5881/mp3-player/schematic and pcb/mp3-1.gif

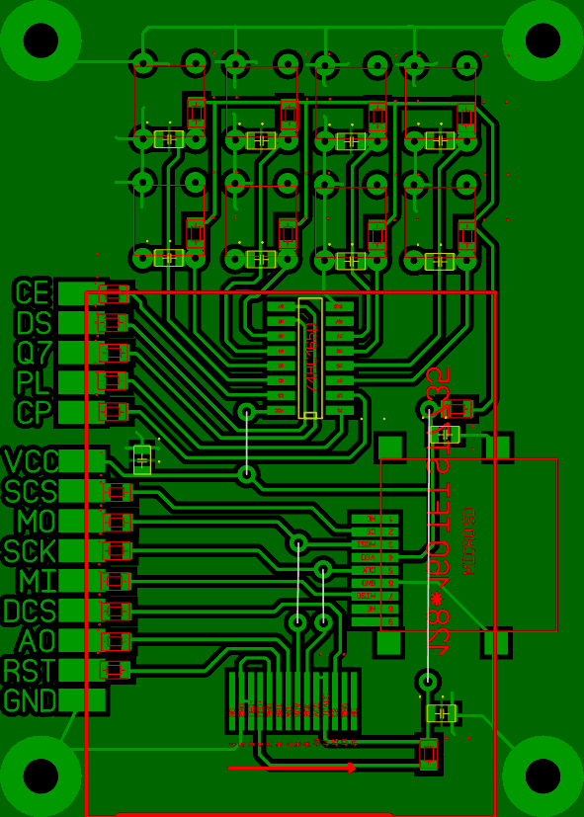
schematic and pcb/mp3-1.gif
