5881/mp3-player/schematic and pcb/mp3-2.gif

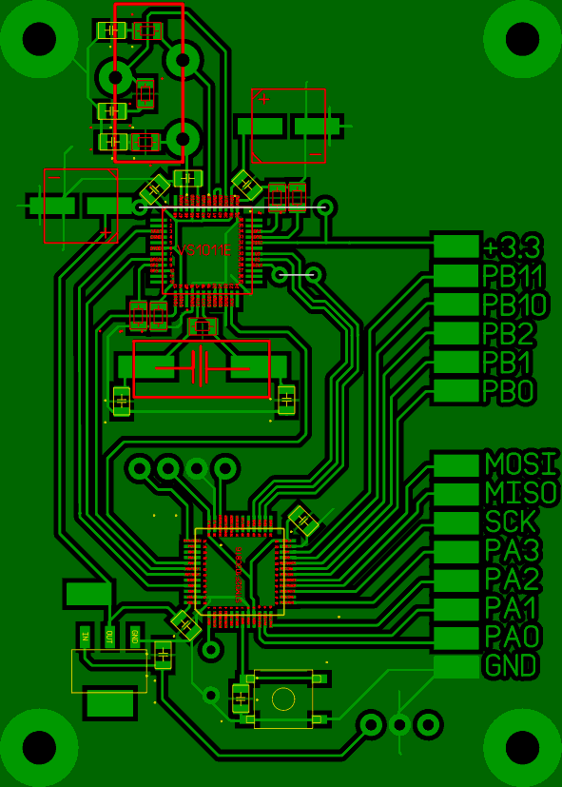
schematic and pcb/mp3-2.gif
