5881/mp3-player/schematic and pcb/mp3.png

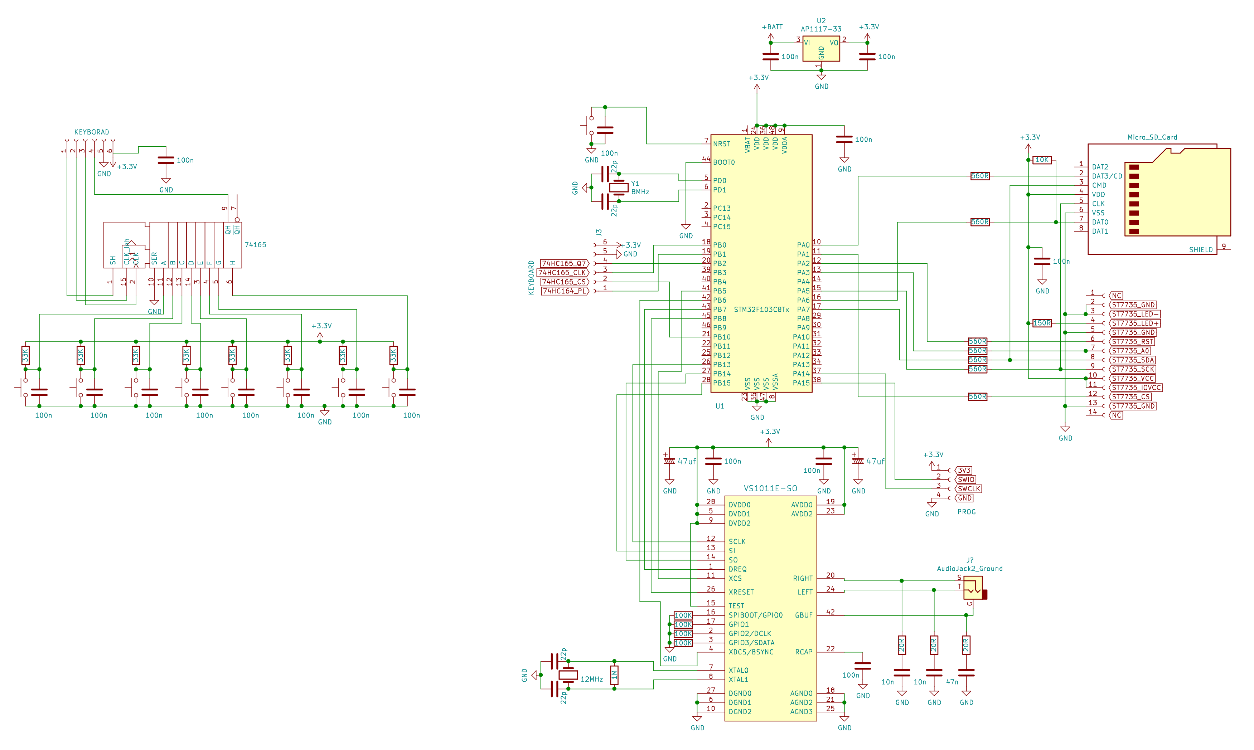
schematic and pcb/mp3.png
