5881/mp3-player/schematic and pcb/mp3.pdf

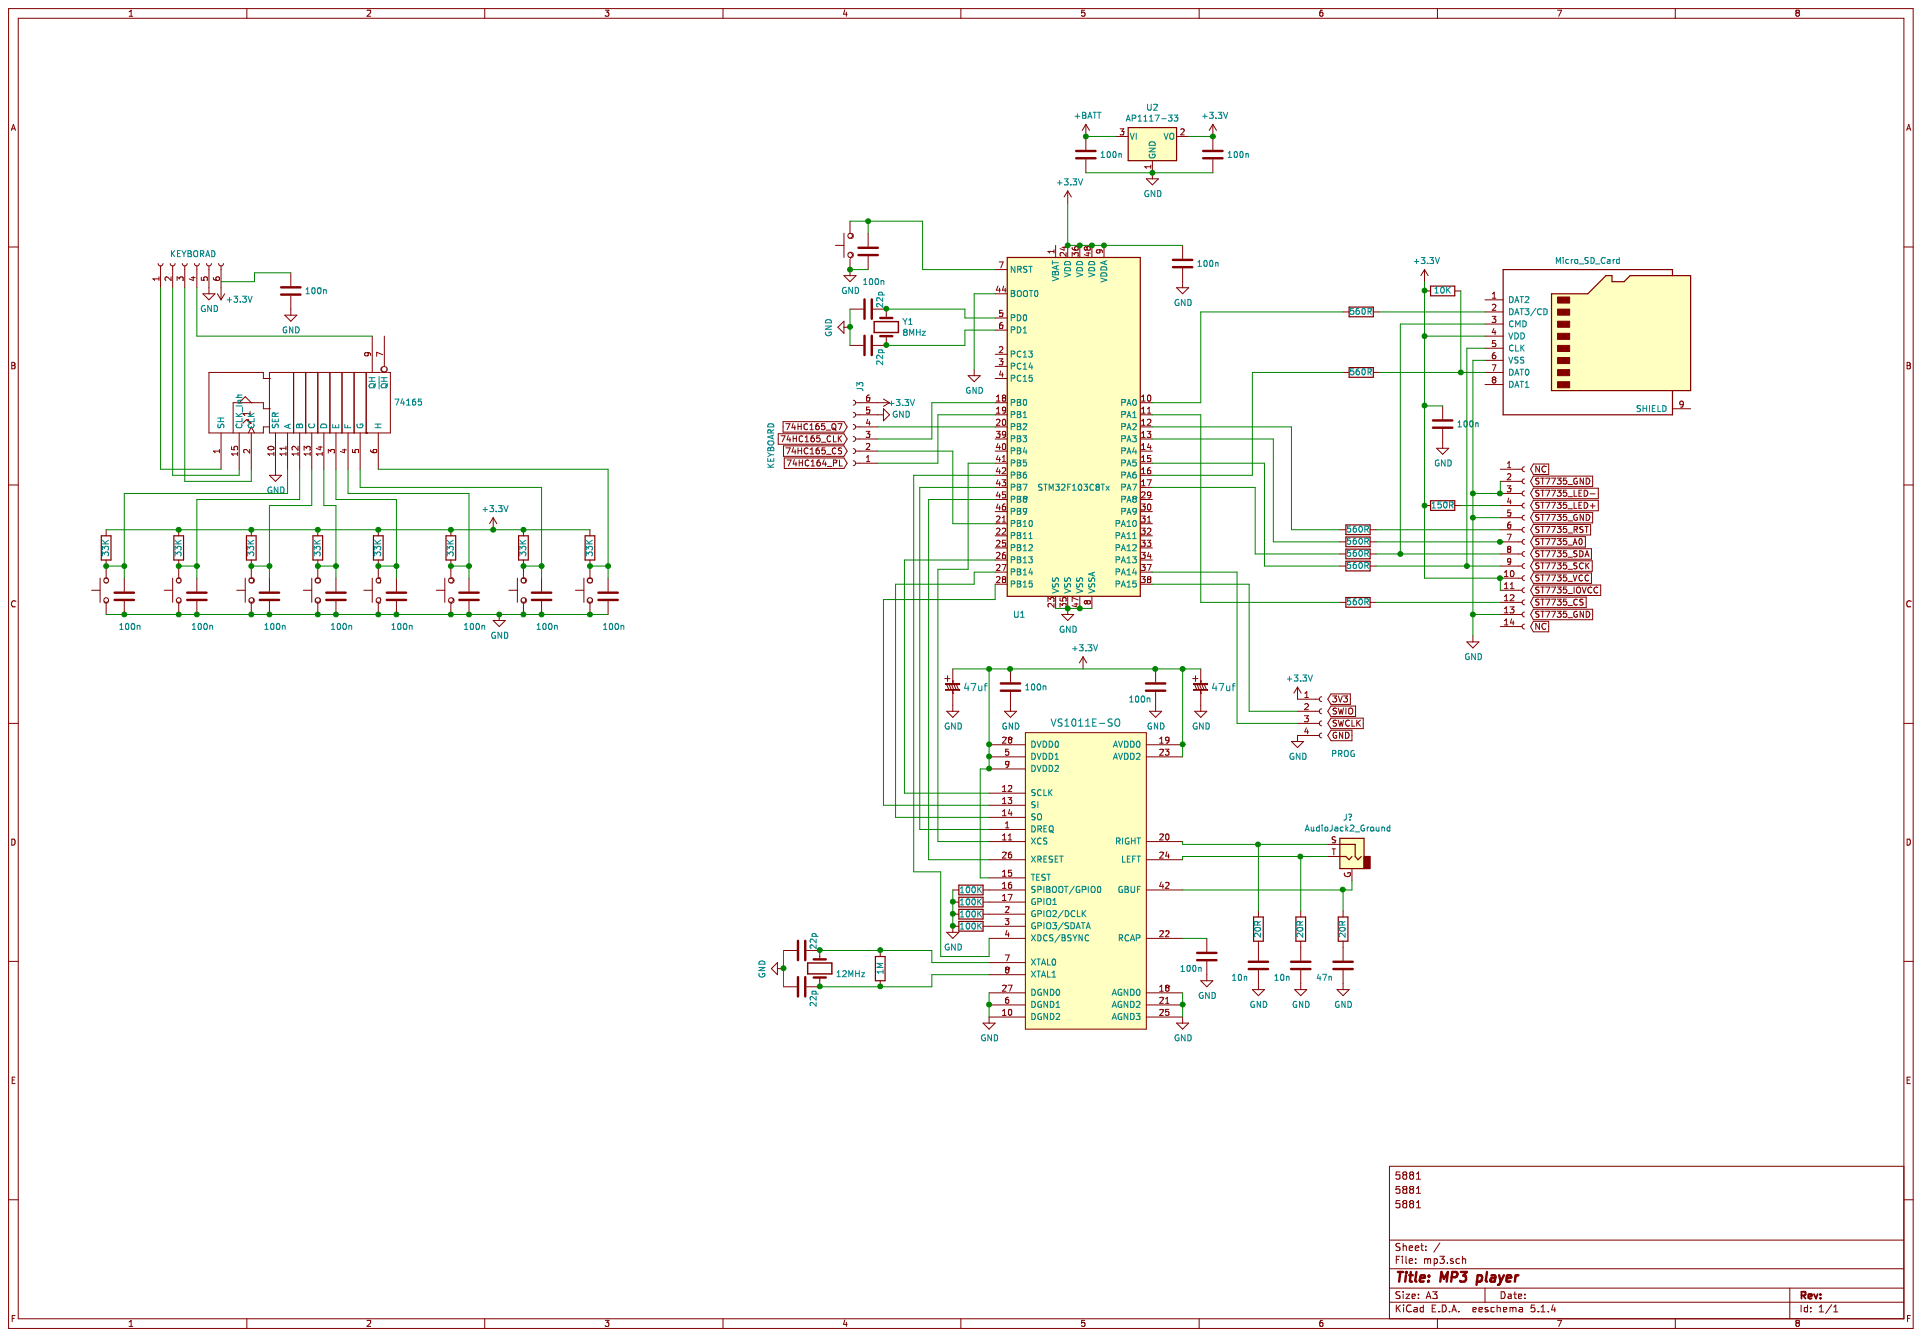
[picture p4: page 1]
