5881/mp3-player/(list of files, drawings)

Other design files:
schematic and pcb/mp3-1.lay6
schematic and pcb/mp3-2.lay6
