5881/mp3-player/schematic and pcb/mp3.sch

## KiCad design schematic and pcb/mp3.sch (2019-12-15)

Schematic: mp3.sch

Parts:
C1, C2, C12, C14, C16, C18, C20, C22, C24, C26, C27: 100n; C_0805_2012Metric
C34, C35: 22p; C_0805_2012Metric
J2: KEYBORAD
J3: KEYBOARD
R2, R4, R6, R8, R10, R12, R14, R16: 33K; R_0805_2012Metric
SW2, SW4, SW6, SW8, SW10, SW12, SW14, SW16: SW_Push; SW_PUSH_6mm
U1: STM32F103C8Tx; LQFP-48_7x7mm_P0.5mm
U2: AP1117-33; SOT-223-3_TabPin2
U6: 74165; SOIC-16_3.9x9.9mm_P1.27mm
Y1: 8MHz; Crystal_SMD_Abracon_ABM3-2Pin_5.0x3.2mm
