5881/mp3-player/inc/st7735_128x160.c

/*Библиотека для работы с tft дисплеем 128x128 st7735
 * v 0.9
 * использована libopencm3
 * 16 mar 2019
 * Alexander Belyy
 * 
 * v0.91
 * добавлено масштабирование текста х2
 * v0.92
 * добавлен вывод побайтно как в терминале 12 мая 2019
 * v0.93
 * добавлена поддержка backspase \b 27 июля 2019
 * v0.94
 * Привёл к пристойному виду. 28 июля 2019
 * v0.95
 * Исправлен баг с CS приводящий к артефактам
 * ошибка была в функции send_char()
 * 10 ноября 2019
 * Добавлена поддержка русской UTF8
 * v0.96
 * 17 ноября 2019
 * исправлена ошибка с печатью первого символа после очистки экрана в
 * st7735_sendchar();
 * 18 ноября 2019
 */
#include <stdint.h>
#include <string.h>
#include <libopencm3/stm32/gpio.h>
#include <libopencm3/stm32/spi.h>
#include "st7735_128x160.h"

/*********************************************************************
 * Секция переменных
 *********************************************************************/
uint16_t pos=0;
static uint16_t txt_color=GREEN;
static uint16_t bg_color=BLACK;

#ifdef UTF8ASCII

//псевдо utf8
//до 00x7f ascii после кирилическая страница без перфиксов
static const char ASCII[][5] =
{
 {0x00, 0x00, 0x00, 0x00, 0x00} // 20  
,{0x00, 0x00, 0x5f, 0x00, 0x00} // 21 !
,{0x00, 0x07, 0x00, 0x07, 0x00} // 22 "
,{0x14, 0x7f, 0x14, 0x7f, 0x14} // 23 #
,{0x24, 0x2a, 0x7f, 0x2a, 0x12} // 24 $
,{0x23, 0x13, 0x08, 0x64, 0x62} // 25 %
,{0x36, 0x49, 0x55, 0x22, 0x50} // 26 &
,{0x00, 0x05, 0x03, 0x00, 0x00} // 27 '
,{0x00, 0x1c, 0x22, 0x41, 0x00} // 28 (
,{0x00, 0x41, 0x22, 0x1c, 0x00} // 29 )
,{0x14, 0x08, 0x3e, 0x08, 0x14} // 2a *
,{0x08, 0x08, 0x3e, 0x08, 0x08} // 2b +
,{0x00, 0x50, 0x30, 0x00, 0x00} // 2c ,
,{0x08, 0x08, 0x08, 0x08, 0x08} // 2d -
,{0x00, 0x60, 0x60, 0x00, 0x00} // 2e .
,{0x20, 0x10, 0x08, 0x04, 0x02} // 2f /
,{0x3e, 0x51, 0x49, 0x45, 0x3e} // 30 0
,{0x00, 0x42, 0x7f, 0x40, 0x00} // 31 1
,{0x42, 0x61, 0x51, 0x49, 0x46} // 32 2
,{0x21, 0x41, 0x45, 0x4b, 0x31} // 33 3
,{0x18, 0x14, 0x12, 0x7f, 0x10} // 34 4
,{0x27, 0x45, 0x45, 0x45, 0x39} // 35 5
,{0x3c, 0x4a, 0x49, 0x49, 0x30} // 36 6
,{0x01, 0x71, 0x09, 0x05, 0x03} // 37 7
,{0x36, 0x49, 0x49, 0x49, 0x36} // 38 8
,{0x06, 0x49, 0x49, 0x29, 0x1e} // 39 9
,{0x00, 0x36, 0x36, 0x00, 0x00} // 3a :
,{0x00, 0x56, 0x36, 0x00, 0x00} // 3b ;
,{0x08, 0x14, 0x22, 0x41, 0x00} // 3c <
,{0x14, 0x14, 0x14, 0x14, 0x14} // 3d =
,{0x00, 0x41, 0x22, 0x14, 0x08} // 3e >
,{0x02, 0x01, 0x51, 0x09, 0x06} // 3f ?
,{0x32, 0x49, 0x79, 0x41, 0x3e} // 40 @
,{0x7e, 0x11, 0x11, 0x11, 0x7e} // 41 A
,{0x7f, 0x49, 0x49, 0x49, 0x36} // 42 B
,{0x3e, 0x41, 0x41, 0x41, 0x22} // 43 C
,{0x7f, 0x41, 0x41, 0x22, 0x1c} // 44 D
,{0x7f, 0x49, 0x49, 0x49, 0x41} // 45 E
,{0x7f, 0x09, 0x09, 0x09, 0x01} // 46 F
,{0x3e, 0x41, 0x49, 0x49, 0x7a} // 47 G
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
};

#else

static const char ASCII[][5] =
{
 {0x00, 0x00, 0x00, 0x00, 0x00} // 20  
,{0x00, 0x00, 0x5f, 0x00, 0x00} // 21 !
,{0x00, 0x07, 0x00, 0x07, 0x00} // 22 "
,{0x14, 0x7f, 0x14, 0x7f, 0x14} // 23 #
,{0x24, 0x2a, 0x7f, 0x2a, 0x12} // 24 $
,{0x23, 0x13, 0x08, 0x64, 0x62} // 25 %
,{0x36, 0x49, 0x55, 0x22, 0x50} // 26 &
,{0x00, 0x05, 0x03, 0x00, 0x00} // 27 '
,{0x00, 0x1c, 0x22, 0x41, 0x00} // 28 (
,{0x00, 0x41, 0x22, 0x1c, 0x00} // 29 )
,{0x14, 0x08, 0x3e, 0x08, 0x14} // 2a *
,{0x08, 0x08, 0x3e, 0x08, 0x08} // 2b +
,{0x00, 0x50, 0x30, 0x00, 0x00} // 2c ,
,{0x08, 0x08, 0x08, 0x08, 0x08} // 2d -
,{0x00, 0x60, 0x60, 0x00, 0x00} // 2e .
,{0x20, 0x10, 0x08, 0x04, 0x02} // 2f /
,{0x3e, 0x51, 0x49, 0x45, 0x3e} // 30 0
,{0x00, 0x42, 0x7f, 0x40, 0x00} // 31 1
,{0x42, 0x61, 0x51, 0x49, 0x46} // 32 2
,{0x21, 0x41, 0x45, 0x4b, 0x31} // 33 3
,{0x18, 0x14, 0x12, 0x7f, 0x10} // 34 4
,{0x27, 0x45, 0x45, 0x45, 0x39} // 35 5
,{0x3c, 0x4a, 0x49, 0x49, 0x30} // 36 6
,{0x01, 0x71, 0x09, 0x05, 0x03} // 37 7
,{0x36, 0x49, 0x49, 0x49, 0x36} // 38 8
,{0x06, 0x49, 0x49, 0x29, 0x1e} // 39 9
,{0x00, 0x36, 0x36, 0x00, 0x00} // 3a :
,{0x00, 0x56, 0x36, 0x00, 0x00} // 3b ;
,{0x08, 0x14, 0x22, 0x41, 0x00} // 3c <
,{0x14, 0x14, 0x14, 0x14, 0x14} // 3d =
,{0x00, 0x41, 0x22, 0x14, 0x08} // 3e >
,{0x02, 0x01, 0x51, 0x09, 0x06} // 3f ?
,{0x32, 0x49, 0x79, 0x41, 0x3e} // 40 @
,{0x7e, 0x11, 0x11, 0x11, 0x7e} // 41 A
,{0x7f, 0x49, 0x49, 0x49, 0x36} // 42 B
,{0x3e, 0x41, 0x41, 0x41, 0x22} // 43 C
,{0x7f, 0x41, 0x41, 0x22, 0x1c} // 44 D
,{0x7f, 0x49, 0x49, 0x49, 0x41} // 45 E
,{0x7f, 0x09, 0x09, 0x09, 0x01} // 46 F
,{0x3e, 0x41, 0x49, 0x49, 0x7a} // 47 G
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
};
#endif

 /********************************************************************
  * Секция основных функций
  ********************************************************************/
void st7735_set_printf_color(uint16_t textcolor, uint16_t bgcolor){
	txt_color=textcolor;
	bg_color=bgcolor;	
}


void st7735_sendcmd(unsigned char cmd){
	gpio_clear(STPORT, DC);
	spi_send(SPI,cmd);
	while (SPI_SR(SPI) & SPI_SR_BSY);
	}
void st7735_senddata(unsigned char data){
	gpio_set(STPORT, DC);
	spi_send(SPI,data);
	while (SPI_SR(SPI) & SPI_SR_BSY);
	}

void st7735_init(void){
	uint32_t i;
	
	//for(i=0;i<0xfff;i++)__asm__("nop");
	gpio_set(STPORT,RST);
	gpio_clear(STPORT,STCS);
	for(i=0;i<0xfff;i++)__asm__("nop");
	gpio_clear(STPORT,RST);
	for(i=0;i<0xfff;i++)__asm__("nop");
	gpio_set(STPORT,RST);
	
	st7735_sendcmd(ST7735_SWRESET);//0x01
	for(i=0;i<0x5fff;i++)__asm__("nop");
	
	st7735_sendcmd(ST7735_SLPOUT);//0x11
	for(i=0;i<0x5fff;i++)__asm__("nop");
	
	st7735_sendcmd(ST7735_COLMOD);
	st7735_senddata(0x5);
	st7735_sendcmd(0x26);
	st7735_senddata(0x2);
	
	st7735_sendcmd(ST7735_FRMCTR1);
	st7735_senddata(0x00);
	st7735_senddata(0x06);
	st7735_senddata(0x03);
	
	st7735_sendcmd(ST7735_MADCTL);
#ifdef HORIZONTAL
	st7735_senddata(MV|MX); //mv set def is 0
#else
	st7735_senddata(0x0);
#endif
	//st7735_sendcmd(ST7735_DISSET5);
	//st7735_senddata(0x15);
	//st7735_senddata(0x02);

	
	st7735_sendcmd(ST7735_CASET);
	st7735_senddata(0x00);
	st7735_senddata(0x00);
	st7735_senddata(0x00);
	st7735_senddata(0x7f);

	st7735_sendcmd(ST7735_RASET);
	st7735_senddata(0x00);
	st7735_senddata(0x00);
	st7735_senddata(0x00);
	st7735_senddata(0xa0);

	
	
	st7735_sendcmd(ST7735_NORON);
	for(i=0;i<0xfff;i++)__asm__("nop");
	
	st7735_sendcmd(ST7735_DISPON);
	for(i=0;i<0xfff;i++)__asm__("nop");
	
		
	while (SPI_SR(SPI) & SPI_SR_BSY);
	gpio_set(GPIOA,STCS);
}

void st7735_wake(void){
	//st7735_init();
	gpio_clear(STPORT,STCS);
	st7735_sendcmd(ST7735_DISPON);
	gpio_set(STPORT,STCS);
	gpio_set(GPIOB,GPIO0);
	}

void st7735_sleep(void){
	gpio_clear(STPORT,STCS);
	st7735_sendcmd(ST7735_DISPOFF);
	gpio_set(STPORT,STCS);
	gpio_clear(GPIOB,GPIO0);
	}

void st7735_addrset(unsigned char sx,unsigned char sy,
								unsigned char ex,unsigned char ey){
	st7735_sendcmd(ST7735_CASET); // Column address set 2a
	gpio_set(GPIOA,DC);
	spi_send(SPI,0x00);
	spi_send(SPI,sx);
	spi_send(SPI,0x00);
	spi_send(SPI,ex);

	while (SPI_SR(SPI) & SPI_SR_BSY);

	st7735_sendcmd(ST7735_RASET);   // Row address set 2b
	gpio_set(GPIOA,DC);
	spi_send(SPI,0x00);
	spi_send(SPI,sy);
	spi_send(SPI,0x00);
	spi_send(SPI,ey);
	
	while (SPI_SR(SPI) & SPI_SR_BSY);
	st7735_sendcmd(ST7735_RAMWR);   // Memory write			
	}

void st7735_clear(uint16_t color){
	unsigned char BCH,BCL;
	BCL = color & 0xFF;
	BCH = color>>8;
	gpio_clear(STPORT,STCS);
	//for(uint8_t i=0;i<0xff;i++)__asm__("nop");

#ifdef HORIZONTAL
	st7735_addrset(0,0,160,128);
#else
	st7735_addrset(0,0,128,160);
#endif
	gpio_set(STPORT,DC);
	for(uint16_t i=0;i<128*160;i++){
		spi_send(SPI,BCH);
		spi_send(SPI,BCL);
		}
	while (SPI_SR(SPI) & SPI_SR_BSY);
	gpio_set(STPORT,STCS);
	}

//debug func

void st7735_draw_s_char(unsigned char x,unsigned char y,char chr,
								uint16_t color, uint16_t bg_color){
										
	unsigned char i,j;
	unsigned char CH,CL,BCH,BCL;
	unsigned char buffer[6];
	CL = color & 0xFF;
	CH = color>>8;
	BCL = bg_color & 0xFF;
	BCH = bg_color>>8;
	
	memcpy(buffer,&ASCII[chr-0x20],5);
	buffer[5]=0;
	
	gpio_clear(STPORT,STCS);
	st7735_addrset(x,y,x+5,y+7);
	gpio_set(GPIOA,DC);
	for(unsigned char i=0;i<8;i++){
		for(unsigned char j=0;j<6;j++){
			if((buffer[j] & (1<<i))){
				spi_send(SPI,CH);
				spi_send(SPI,CL);
				}
				else{
				spi_send(SPI,BCH);
				spi_send(SPI,BCL);
				}
			}
		}
	
	while (SPI_SR(SPI) & SPI_SR_BSY);
	gpio_set(STPORT,STCS);

}

//end debug func

void st7735_drawchar(unsigned char x,unsigned char y,char chr,
								uint16_t color, uint16_t bg_color){
	gpio_clear(STPORT,STCS);
	unsigned char i,j;
	unsigned char CH,CL,BCH,BCL;
	unsigned char buffer[6];
	//добавлена поддержка кирилицы
	unsigned char c=(chr<0xe0) ? chr - 0x20 : chr - 0x50;
	
	CL = color & 0xFF;
	CH = color>>8;
	BCL = bg_color & 0xFF;
	BCH = bg_color>>8;
	
	memcpy(buffer,&ASCII[c],5);
	buffer[5]=0;
	st7735_addrset(x,y,x+5,y+7);
	gpio_set(STPORT,DC);
	for(unsigned char i=0;i<8;i++){
		for(unsigned char j=0;j<6;j++){
			if((buffer[j] & (1<<i))){
				spi_send(SPI,CH);
				spi_send(SPI,CL);
				}
				else{
				spi_send(SPI,BCH);
				spi_send(SPI,BCL);
				}
			}
		}
	while (SPI_SR(SPI) & SPI_SR_BSY);
	gpio_set(STPORT,STCS);
	}

void st7735_drawchar_x2(unsigned char x,unsigned char y,char chr,
								uint16_t color, uint16_t bg_color){
	gpio_clear(STPORT,STCS);
	unsigned char i,j;
	unsigned char CH,CL,BCH,BCL;
	unsigned char buffer[6];
	//добавлена поддержка кирилицы
	unsigned char c=(chr<0xe0) ? chr - 0x20 : chr - 0x50;
	
	uint16_t temp;
	CL = color & 0xFF;
	CH = color>>8;
	BCL = bg_color & 0xFF;
	BCH = bg_color>>8;
	
	memcpy(buffer,&ASCII[c],5);
	buffer[5]=0;
	st7735_addrset(x,y,x+11,y+15);
	gpio_set(STPORT,DC);
	
	
	for(uint8_t j=0;j<8;j++){
		for(uint8_t k=0;k<2;k++){
			for(uint8_t i=0;i<6;i++){
				if(buffer[i]&(1<<j)) {//если окрашено
					spi_send(SPI,CH);
					spi_send(SPI,CL);
					spi_send(SPI,CH);
					spi_send(SPI,CL);}
					else {			//фон
					spi_send(SPI,BCH);
					spi_send(SPI,BCL);
					spi_send(SPI,BCH);
					spi_send(SPI,BCL);}
				}
		}
	}
	while (SPI_SR(SPI) & SPI_SR_BSY);
	gpio_set(STPORT,STCS);
	}

void st7735_drawchar_x3(unsigned char x,unsigned char y,char chr,
								uint16_t color, uint16_t bg_color){
	gpio_clear(STPORT,STCS);
	unsigned char i,j;
	unsigned char CH,CL,BCH,BCL;
	unsigned char buffer[6];
	//добавлена поддержка кирилицы
	unsigned char c=(chr<0xe0) ? chr - 0x20 : chr - 0x50;
	
	uint16_t temp;
	CL = color & 0xFF;
	CH = color>>8;
	BCL = bg_color & 0xFF;
	BCH = bg_color>>8;
	
	memcpy(buffer,&ASCII[c],5);
	buffer[5]=0;
	st7735_addrset(x,y,x+17,y+23);
	gpio_set(GPIOA,DC);
	
	for(uint8_t j=0;j<8;j++){
		for(uint8_t k=0;k<3;k++){
			for(uint8_t i=0;i<6;i++){
				if(buffer[i]&(1<<j)) {//если окрашено
					spi_send(SPI,CH);
					spi_send(SPI,CL);
					spi_send(SPI,CH);
					spi_send(SPI,CL);
					spi_send(SPI,CH);
					spi_send(SPI,CL);}
					else {			//фон
					spi_send(SPI,BCH);
					spi_send(SPI,BCL);
					spi_send(SPI,BCH);
					spi_send(SPI,BCL);
					spi_send(SPI,BCH);
					spi_send(SPI,BCL);}
				}
		}
	}
	while (SPI_SR(SPI) & SPI_SR_BSY);
	gpio_set(STPORT,STCS);
	}

void st7735_string_x3_at(unsigned char x,unsigned char y,
				unsigned char *chr,	uint16_t color, uint16_t bg_color){
	//gpio_clear(STPORT,STCS);
	//for (uint8_t i=0;i<50;i++) __asm__("nop");//задержка против глюков
	unsigned char i=0;
	while(*chr){
#ifdef UTF8ASCII
		if(*chr==0xd0||*chr==0xd1) chr++;
#endif
		if(*chr=='\n'){y+=24;chr++;i=0;}
		st7735_drawchar_x3(x+i,y,*chr++,color,bg_color);
		i+=17;
		}
	while (SPI_SR(SPI) & SPI_SR_BSY);
	//gpio_set(STPORT,STCS);  
	}

void st7735_string_x2_at(unsigned char x,unsigned char y,
				unsigned char *chr,	uint16_t color, uint16_t bg_color){
	//gpio_clear(STPORT,STCS);
	//for (uint8_t i=0;i<50;i++) __asm__("nop");
	unsigned char i=0;
	while(*chr){
#ifdef UTF8ASCII
		if(*chr==0xd0||*chr==0xd1) chr++;
#endif
		if(*chr=='\n'){y+=16;chr++;i=0;}
		st7735_drawchar_x2(x+i,y,*chr++,color,bg_color);
		i+=11;
		}
	while (SPI_SR(SPI) & SPI_SR_BSY);
	//gpio_set(STPORT,STCS);  
	}



void st7735_string_at(unsigned char x,unsigned char y,
				unsigned char *chr,	uint16_t color, uint16_t bg_color){
	//gpio_clear(STPORT,STCS);
	//for (uint8_t i=0;i<50;i++) __asm__("nop");
	unsigned char i=0;
	while(*chr){
		if(*chr==0xd0||*chr==0xd1) chr++;
		if(*chr=='\n'){y+=8;chr++;i=0;}
		st7735_drawchar(x+i,y,*chr++,color,bg_color);
		i+=6;
		}
	//while (SPI_SR(SPI) & SPI_SR_BSY);
	//gpio_set(STPORT,STCS);  
	}
	
void st7735_drawpixel(unsigned char x,unsigned char y,uint16_t Color){
	unsigned char CL,CH;
	CL = Color & 0xFF;
	CH = (Color>>8) & 0xFF;
	st7735_addrset(x,y,x+1,y+1);
	gpio_set(STPORT,DC);
	spi_send(SPI,CH);
	spi_send(SPI,CL);
	while (SPI_SR(SPI) & SPI_SR_BSY);
	}
	
/**********************************************************************
 * рисование линий с помощью  Алгоритм Брезенхэма
 * https://ru.wikibooks.org/
 **********************************************************************/

void st7735_drawline(unsigned char x1, unsigned char y1,unsigned char x2,
						           unsigned char y2, uint16_t color){
	gpio_clear(STPORT,STCS); //перенёс сюда чтобы сделать задержку
    char deltax,deltay,signx,signy;
    deltax = x2 - x1;
    if(deltax<0) deltax*=-1;
    deltay = y2 - y1;
    if(deltay<0) deltay*=-1;
    signx = x1 < x2 ? 1 : -1;
    signy = y1 < y2 ? 1 : -1;
    //
    short int error = deltax - deltay, error2;
    //
    
    st7735_drawpixel(x2, y2,color);
		while(x1 != x2 || y1 != y2){
			st7735_drawpixel(x1, y1,color);
			error2 = error * 2;
			//
			if(error2 > -deltay){
				error -= deltay;
				x1 += signx;
				}
			if(error2 < deltax){
				error += deltax;
				y1 += signy;
				}
		}
	while (SPI_SR(SPI) & SPI_SR_BSY);
	gpio_set(STPORT,STCS);
	}


void st7735_drawcircle(unsigned char x0, unsigned char y0,
							unsigned char radius, uint16_t color) {
	gpio_clear(STPORT,STCS);//здесь для задержки
	short int x = 0;
	short int y = radius;
	short int delta = 1 - 2 * radius;
	short int error = 0;
	while(y >= 0) {
		st7735_drawpixel(x0 + x, y0 + y,color);
		st7735_drawpixel(x0 + x, y0 - y,color);
		st7735_drawpixel(x0 - x, y0 + y,color);
		st7735_drawpixel(x0 - x, y0 - y,color);
		error = 2 * (delta + y) - 1;
		if(delta < 0 && error <= 0) {
			++x;
			delta += 2 * x + 1;
			continue;
			}
		error = 2 * (delta - x) - 1;
		if(delta > 0 && error > 0) {
			--y;
			delta += 1 - 2 * y;
			continue;
			}
		++x;
		delta += 2 * (x - y);
		--y;
		}
	while (SPI_SR(SPI) & SPI_SR_BSY);
	gpio_set(STPORT,STCS);
	}

void st7735_drawhl(unsigned char x,unsigned char x1,
									unsigned char y,uint16_t color){
	unsigned char len,CL,CH;
	CL = color & 0xFF;
	CH = color>>8;
	st7735_addrset(x,y,x1,y);
	len = x1-x;
	gpio_set(STPORT,DC);
	for(unsigned char i=0;i<len;i++){
		spi_send(SPI,CH);
		spi_send(SPI,CL);
		}
	while (SPI_SR(SPI) & SPI_SR_BSY);
}

void st7735_drawvl(unsigned char x,unsigned char y,
									unsigned char y1,uint16_t color){
	unsigned char len,CL,CH;
	CL = color & 0xFF;
	CH = color>>8;
	st7735_addrset(x,y,x,y1);
	len = y1-y;
	gpio_set(STPORT,DC);
	for(unsigned char i=0;i<len;i++){
		spi_send(SPI,CH);
		spi_send(SPI,CL);
		}
	while (SPI_SR(SPI) & SPI_SR_BSY);
}

void st7735_drawrectangle(unsigned char x, unsigned char y,
				unsigned char dx, unsigned char dy, uint16_t color){
	gpio_clear(STPORT,STCS);
	//for (uint8_t i=0;i<50;i++) __asm__("nop");
	st7735_drawhl(x,x+dx,y,color);										
	st7735_drawvl(x+dx,y,y+dy,color);
	st7735_drawvl(x,y,y+dy,color);
	st7735_drawhl(x,x+dx,y+dy,color);
	while (SPI_SR(SPI) & SPI_SR_BSY);
	gpio_set(STPORT,STCS);					
	}
	
void st7735_drawimg(uint8_t x,uint8_t y, uint8_t w,uint8_t h, uint16_t *data){
	gpio_clear(STPORT,STCS);
	//for (uint8_t i=0;i<50;i++) __asm__("nop");
	st7735_addrset(x,y,x+w+1,y+h);
	//uint32_t size=h*w-1;
	uint32_t size=h*w;
	gpio_set(STPORT,DC);
	
	for(uint32_t i=0;i<size;i++){
				spi_send(SPI,data[i]>>8);
				spi_send(SPI,data[i]&0xff);
		//spi_send(SPI,Oxff);
//spi_send(SPI,Oxff);
		}
	while (SPI_SR(SPI) & SPI_SR_BSY);
	gpio_set(STPORT,STCS);	
}	
	
void st7735_drawgimg(uint8_t x,uint8_t y, uint8_t w,uint8_t h, uint8_t *data){
	gpio_clear(STPORT,STCS);
	for (uint8_t i=0;i<50;i++) __asm__("nop");
	st7735_addrset(x,y,x+w,y+h);
	uint32_t size=h*w*2;
	gpio_set(STPORT,DC);
	
	for(uint32_t i=0;i<size+1;i++)spi_send(SPI,data[i]);
	while (SPI_SR(SPI) & SPI_SR_BSY);
	gpio_set(STPORT,STCS);	
}	


//задефайнить горизонтальный и вертикальный режимы
void st7735_sendchar(char ch){
#ifdef UTF8ASCII
	if(ch==0xd0||ch==0xd1) return;
#endif
	//gpio_clear(STPORT,STCS);
	//for (uint8_t i=0;i<50;i++) __asm__("nop");
	//static uint16_t pos=0;
	uint16_t px,py;
#ifdef HORIZONTAL	
	if(ch=='\r'){
		pos-=pos%26;
	#ifdef DEBUG
		ch='R';}
	#else
		//gpio_set(STPORT,STCS);
		return;}
	#endif
	if(ch=='\n'){
		pos+=26;
		pos-=pos%26;
	#ifdef DEBUG
		ch='N';}
	#else
		//gpio_set(STPORT,STCS);
		return;}
	#endif	
		if(ch=='\a'){
		pos=0;
		st7735_clear(bg_color);
		//gpio_set(STPORT,STCS);
		return;}
	if(ch=='\b'){//backspase new!
	pos--;
	px=pos%26*6;
	py=pos/26*8;
	st7735_drawchar(px,py,0x20,txt_color,bg_color);
	//gpio_set(STPORT,STCS);
	return;}
	if(pos>CHAR_ON_SCREEN){ //26*16=416 а на одну строку меньше 390
		st7735_clear(bg_color);
		pos=0;
		}
	px=pos%26*6;
	py=pos/26*8;
#else
	if(ch=='\r'){
		pos-=pos%21;
		//gpio_set(STPORT,STCS);
		return;}
	if(ch=='\n'){
		pos+=21;
		pos-=pos%21;
		//gpio_set(STPORT,STCS);
		return;}
	if(ch=='\a'){
		pos=0;
		st7735_clear(bg_color);
		//gpio_set(STPORT,STCS);
		return;}
	if(ch=='\b'){//backspase new!
	pos--;
	px=pos%21*6;
	py=pos/21*8;
	st7735_drawchar(px,py,' ',txt_color,bg_color);
	//gpio_set(STPORT,STCS);
	return;
	}
	if(pos>420){
		pos=0;
		st7735_clear(BLACK);}
	px=pos%21*6;
	py=pos/21*8;
#endif

	st7735_drawchar(px,py,ch,txt_color,bg_color);
	pos++;
	
	
	//gpio_set(STPORT,STCS);
	//return;
	}

void st7735_progress_bar(uint8_t y,uint8_t value,
									uint16_t color,uint16_t bgcolor){
	char bar[27];
	uint8_t i, count=value*26/256;
	for(i=0;i<count;i++)bar[i]='=';
	bar[count]='>';
	for(i=count+1;i<26;i++)bar[i]='-';
	bar[26]=0;
	st7735_string_at(0,y,bar,color,bgcolor);
	} 


void st7735_virt_sendchar(char ch){
#ifdef UTF8ASCII
	if(ch==0xd0||ch==0xd1) return;
#endif
	//gpio_clear(STPORT,STCS);
	//for (uint8_t i=0;i<50;i++) __asm__("nop");
	//static uint16_t pos=0;
	uint16_t px,py;
#ifdef HORIZONTAL	
	px=pos%26*6;
	py=pos/26*8;
#else
	px=pos%21*6;
	py=pos/21*8;
#endif
	if(ch>0x20)	st7735_drawchar(px,py,ch,RED,bg_color);
	//pos++;
	//while (SPI_SR(SPI) & SPI_SR_BSY);
	//gpio_set(STPORT,STCS);
	//return;
	}
