5881/mp3-player/(commit log)

2019-12-15 PCB and schematic
    [mp3-1.lay6, mp3-2.lay6, mp3.sch]
2020-01-26 Добавлена блокировка клавиатуры
2020-06-21 добавленна поддержка прейлиста
